fiuba-labo-de-micro-miercoles/2016_1c_trabajo_practico-solar_tracker/README.md

# Solar Tracker

Para configurar el oscilador externo a 8MHz:

  avrdude -c usbtiny -p m88 -U lfuse:r:-:i -F		
  avrdude -c usbtiny -p m88 -U lfuse:w:0xE2:m -F

# ¡GRACIAS A LOS QUE HICIERON POSIBLE ESTE PROYECTO!
