fiuba-labo-de-micro-miercoles/2016_1c_trabajo_practico-solar_tracker/(threads)

Thread 1 (2016-05-19):

Crear pdf con el esquemático

ggavinowich, 2016-05-19:
Hola, buenísimo que hayan subido el esquemático. ¿Pueden por favor subir una versión en pdf para que podamos verla sin tener que instalar el Kicad?

Mecanigio, 2016-05-26:
Perdon, recien lo veo! ahi subi el esquemático en pdf.

Saludos!

Equipo Solar Tracker.

Closed 2016-05-26.

Thread 2 (2016-05-30):

¿Parte de mecánica?

fbaglivo, 2016-05-30:
Estimados, buenísimo que mantengan actualizado el repo.

Les quería preguntar si uds ya tienen resuelta la parte mecánica (como montar el panel, si van a hacer algo a escala y van a usar un panel chico, etc).

GedSid, 2016-05-30:
Estamos en eso, tenemos un par de cosas resueltas y un par más por
resolver. Durante esta semana esperamos resolverlo, para la semana que
viene inprimir los engranajes.
La idea es no hacer una maqueta, sino el aparato definitivo.

Saludos,
Joaquín Ulloa
El 30/05/2016 14:55, "fbaglivo" <notifications@github.com> escribió:

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

Closed 2016-06-03.
