fiuba-labo-de-micro-miercoles/2016_1c_trabajo_practico-solar_tracker/esquematico/TP LDM KICAD/Archivos_Frabricacion/TP-F.Cu.pdf

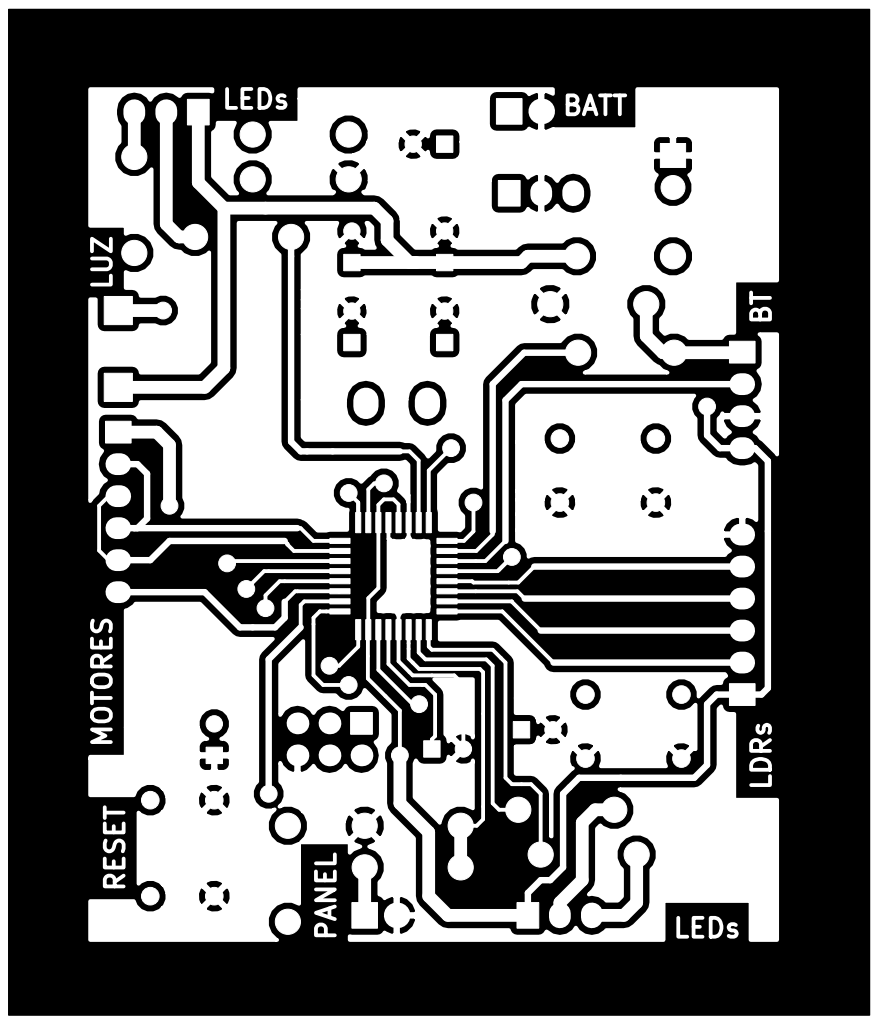
[picture p8: page 1]

BT LDRs PANEL LEDs RESET MOTORES LUZ
