fiuba-labo-de-micro-miercoles/2016_1c_trabajo_practico-solar_tracker/esquematico/TP LDM KICAD/ESQUEMATICO.pdf

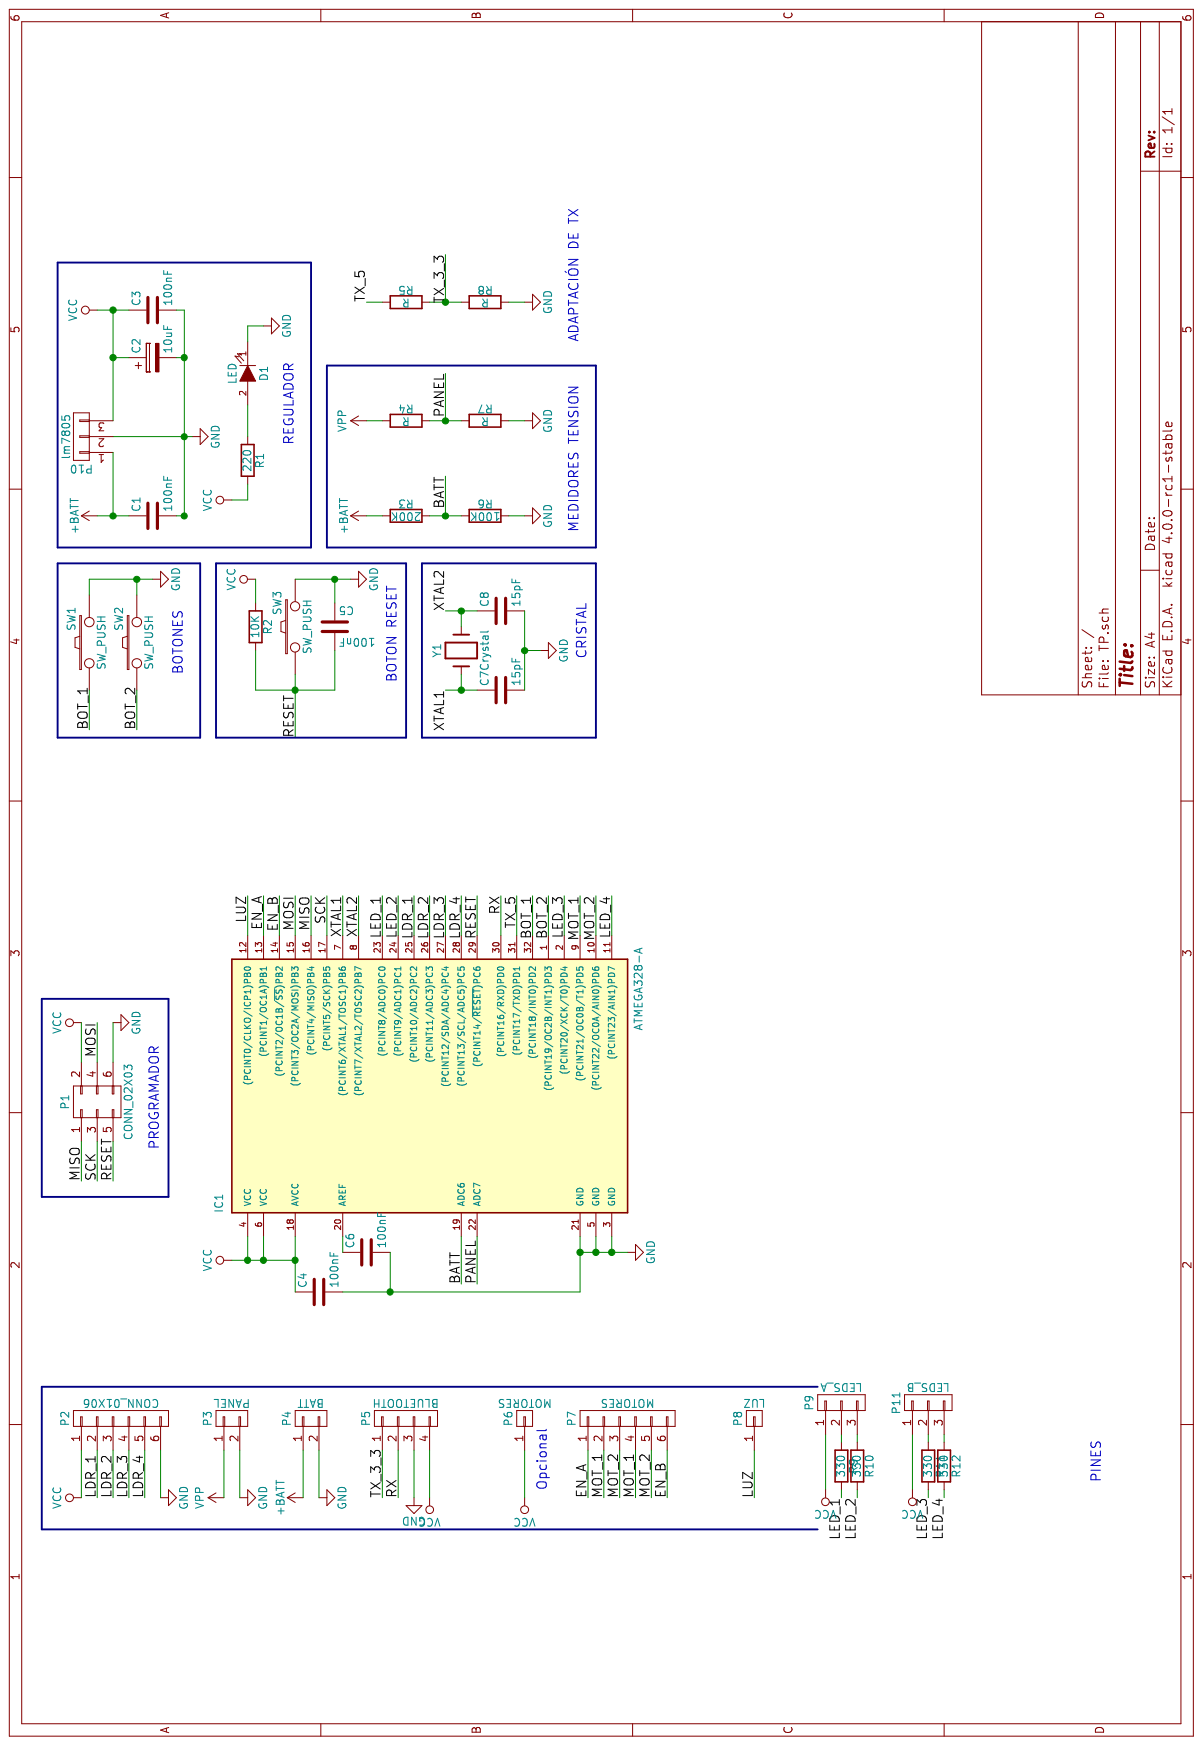
[picture p9: page 1]
