fiuba-labo-de-micro-miercoles/2016_1c_trabajo_practico-solar_tracker/esquematico/TP LDM KICAD/Archivos_Frabricacion/TP-B.Cu.pdf

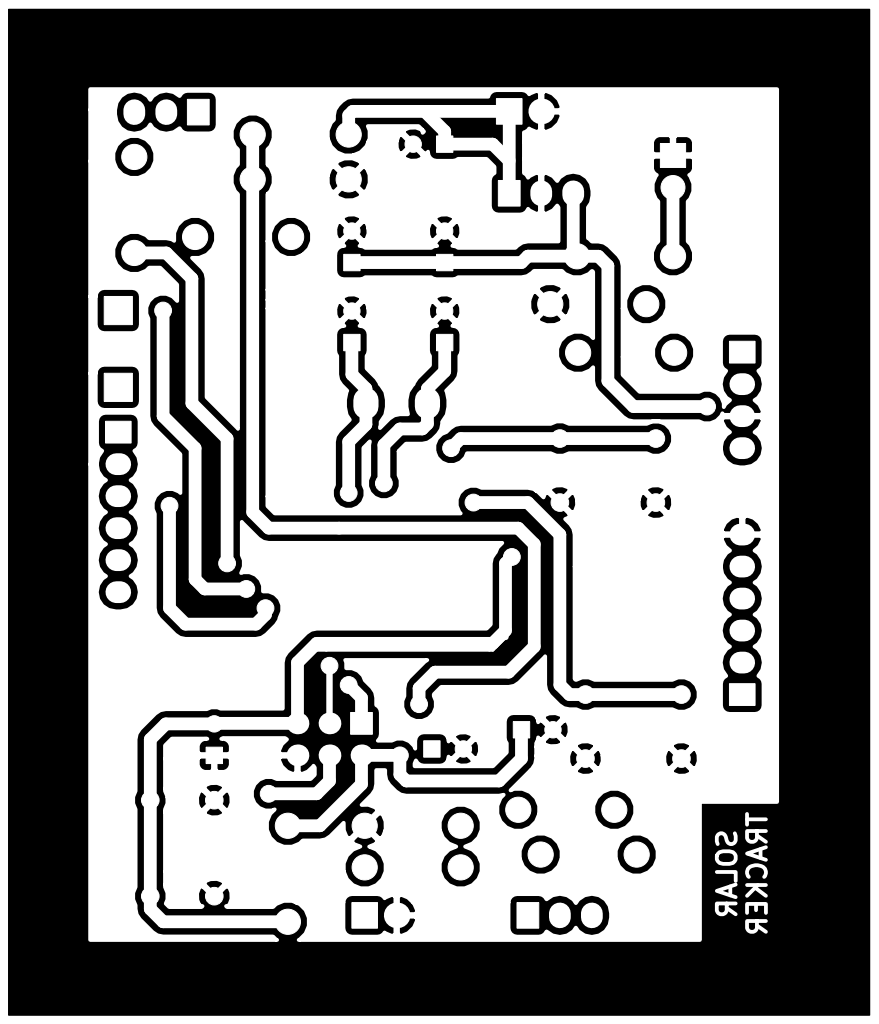
[picture p10: page 1]
