fiuba-labo-de-micro-miercoles/2016_1c_trabajo_practico-solar_tracker/esquematico/TP LDM KICAD/TP.kicad_pcb

## KiCad design esquematico/TP LDM KICAD/TP.kicad_pcb (2016-05-13)

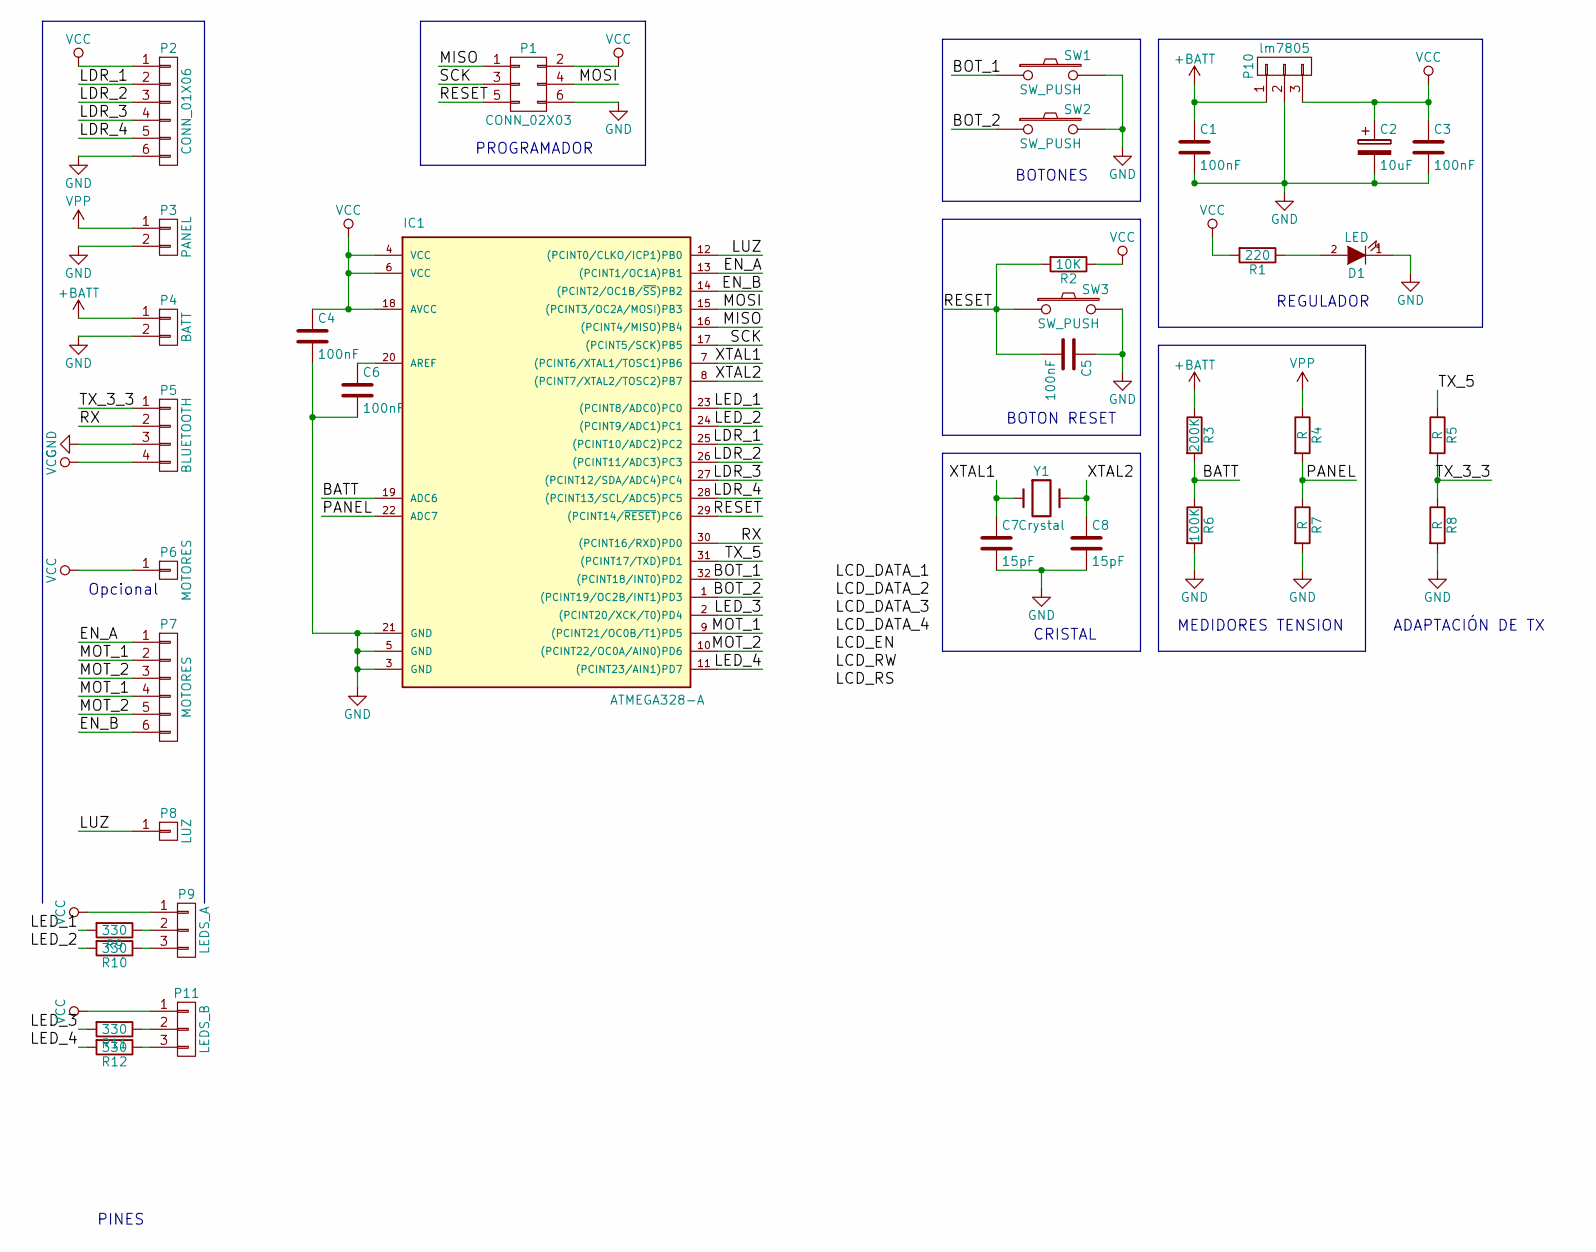
[picture p11: schematic TP.sch]

Parts:
C1, C3, C4, C5, C6: 100nF; C_Radial_D5_L6_P2.5
C2: 10uF; C_Radial_D5_L6_P2.5
C7, C8: 15pF; C_Radial_D5_L6_P2.5
D1: LED; LED-5MM
IC1: ATMEGA328-A; ATMEGA328PARALCI
P1: CONN_02X03; Pin_Header_Straight_2x03
P2: CONN_01X06; Pin_Header_Straight_1x06
P3: PANEL; Pin_Header_Straight_1x02
P4: BATT; Pin_Header_Straight_1x02
P5: BLUETOOTH; Pin_Header_Straight_1x04
P6: MOTORES; Pin_Header_Straight_1x01
P7: MOTORES; Pin_Header_Straight_1x06
P8: LUZ; Pin_Header_Straight_1x01
P9: LEDS_A; Pin_Header_Straight_1x03
P10: lm7805; Pin_Header_Straight_1x03
P11: LEDS_B; Pin_Header_Straight_1x03
R1: 220; Resistor_Horizontal_RM7mm
R2: 10K; Resistor_Horizontal_RM7mm
R3: 200K; Resistor_Horizontal_RM7mm
R4, R5, R7, R8: R; Resistor_Horizontal_RM7mm
R6: 100K; Resistor_Horizontal_RM7mm
R9, R10, R11, R12: 330; Resistor_Horizontal_RM7mm
SW1, SW2, SW3: SW_PUSH; SW_PUSH_SMALL
Y1: Crystal; Crystal_HC50-U_Vertical

Connections:
+BATT: C1.1, P4.1, P10.1, R3.1
/BATT: IC1.19 (ADC6), R3.2, R6.1
/BOT_1: IC1.32 ((PCINT18/INT0)PD2), SW1.1
/BOT_2: IC1.1 ((PCINT19/OC2B/INT1)PD3), SW2.1
/EN_A: IC1.13 ((PCINT1/OC1A)PB1), P7.1
/EN_B: IC1.14 ((PCINT2/OC1B/~SS~)PB2), P7.6
/LDR_1: IC1.25 ((PCINT10/ADC2)PC2), P2.2
/LDR_2: IC1.26 ((PCINT11/ADC3)PC3), P2.3
/LDR_3: IC1.27 ((PCINT12/SDA/ADC4)PC4), P2.4
/LDR_4: IC1.28 ((PCINT13/SCL/ADC5)PC5), P2.5
/LED_1: IC1.23 ((PCINT8/ADC0)PC0), R9.2
/LED_2: IC1.24 ((PCINT9/ADC1)PC1), R10.2
/LED_3: IC1.2 ((PCINT20/XCK/T0)PD4), R11.2
/LED_4: IC1.11 ((PCINT23/AIN1)PD7), R12.2
/LUZ: IC1.12 ((PCINT0/CLKO/ICP1)PB0), P8.1
/MISO: IC1.16 ((PCINT4/MISO)PB4), P1.1
/MOSI: IC1.15 ((PCINT3/OC2A/MOSI)PB3), P1.4
/MOT_1: IC1.9 ((PCINT21/OC0B/T1)PD5), P7.2, P7.4
/MOT_2: IC1.10 ((PCINT22/OC0A/AIN0)PD6), P7.3, P7.5
/PANEL: IC1.22 (ADC7), R4.2, R7.1
/RESET: C5.2, IC1.29 ((PCINT14/~RESET~)PC6), P1.5, R2.2, SW3.1
/RX: IC1.30 ((PCINT16/RXD)PD0), P5.2
/SCK: IC1.17 ((PCINT5/SCK)PB5), P1.3
/TX_3_3: P5.1, R5.2, R8.1
/TX_5: IC1.31 ((PCINT17/TXD)PD1), R5.1
/XTAL1: C7.1, IC1.7 ((PCINT6/XTAL1/TOSC1)PB6), Y1.1
/XTAL2: C8.1, IC1.8 ((PCINT7/XTAL2/TOSC2)PB7), Y1.2
GND: C1.2, C2.2, C3.2, C4.2, C5.1, C6.2, C7.2, C8.2, D1.1 (K), IC1.3 (GND), IC1.5 (GND), IC1.21 (GND), P1.6, P2.6, P3.2, P4.2, P5.3, P10.2, R6.2, R7.2, R8.2, SW1.2, SW2.2, SW3.2
unnamed: C6.1, IC1.20 (AREF)
unnamed: D1.2 (A), R1.1
unnamed: P9.2, R9.1
unnamed: P9.3, R10.1
unnamed: P11.2, R11.1
unnamed: P11.3, R12.1
VCC: C2.1, C3.1, C4.1, IC1.4 (VCC), IC1.6 (VCC), IC1.18 (AVCC), P1.2, P2.1, P5.4, P6.1, P9.1, P10.3, P11.1, R1.2, R2.1
VPP: P3.1, R4.1

Notes on the sheet:
Opcional
BOTONES
BOTON RESET
CRISTAL
PINES
REGULADOR
MEDIDORES TENSION
PROGRAMADOR
ADAPTACIÓN DE TX

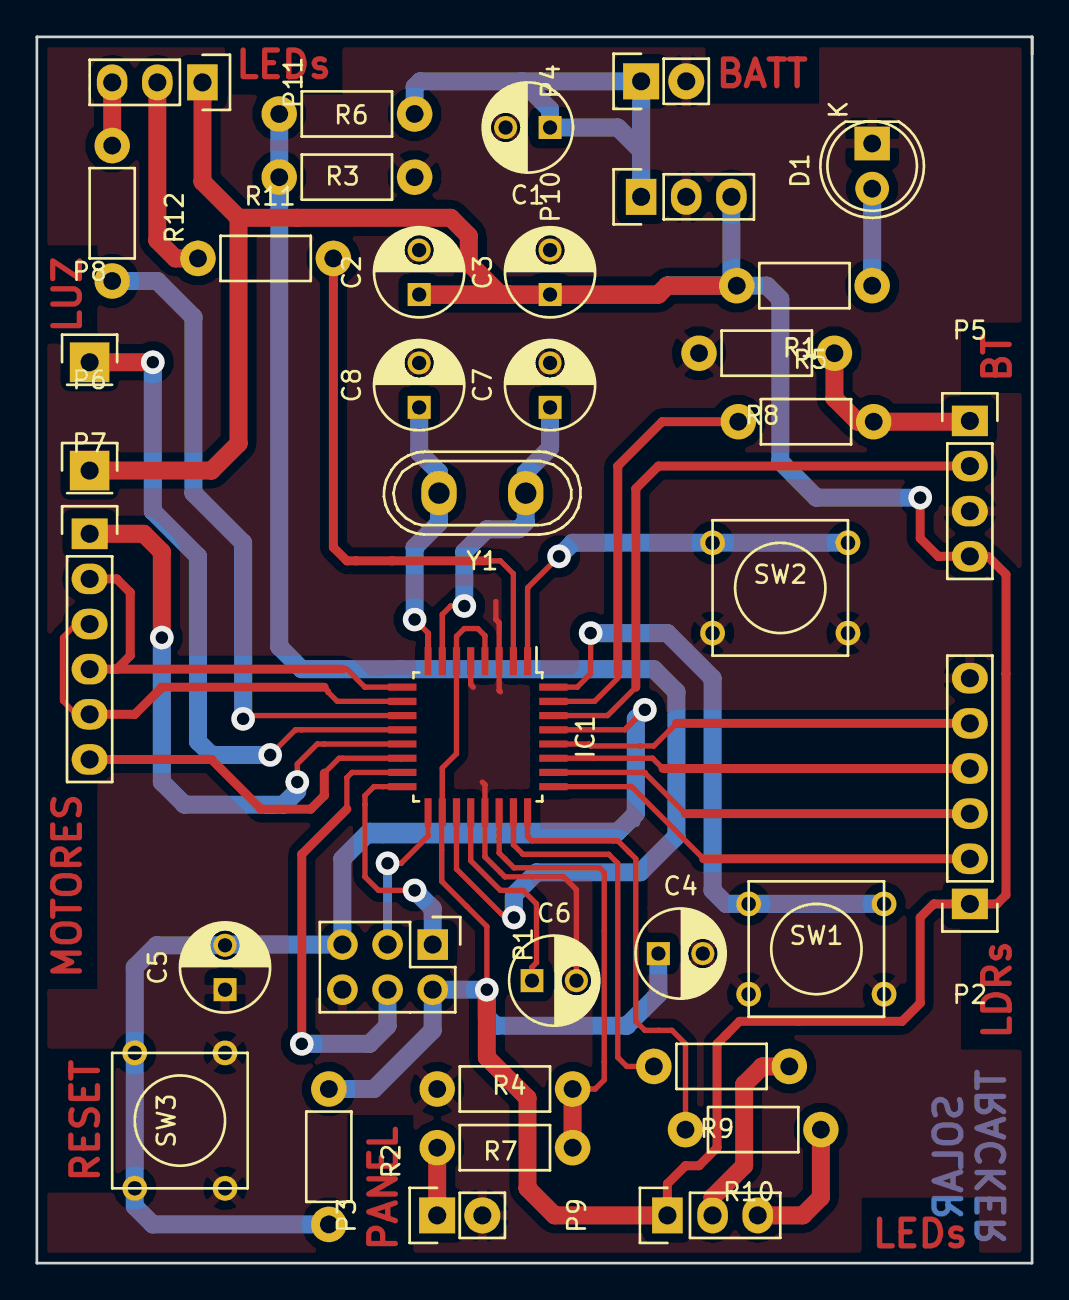
[picture p12: board TP.kicad_pcb from above]

Board: 2 copper layers, 56.0 x 69.0 mm, 37 parts (0 on the bottom side), 36 nets.
