fiuba-labo-de-micro-miercoles/2016_1c_trabajo_practico-solar_tracker/(commit log)

2016-05-11 Add files via upload
    Se sube el anteproyecto.
2016-05-11 Add files via upload
    Se suben los diagramas de flujo y bloques
2016-05-11 Add files via upload
    Se sube la convención de uso de registros preliminar.
2016-05-11 Add files via upload
    Se sube la hoja de datos de la familia del micro a usar
2016-05-13 Ahí subí el proyecto en kicad. SEGURO tira error en el ATMEGA328PARALCI.kicad_mod cuando vayas a seguir ruteando Joaco.
    [TP.kicad_pcb, TP.sch]
2016-05-13 V 1.0 terminada PCB micro + archivos fabricacion LCI
    [TP.kicad_pcb, TP.sch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]
2016-05-13 agrego RAR con archivos de fabricacion
2016-05-13 Ya tenemos puerto serie para el atmega88pa
2016-05-19 prueba con el bluetooth [esta mal el nombre]
2016-05-26 Prueba del ADC.. para variar no anda tdv jaja
2016-05-27 Codigo PWM. A las dos salidas de 8bit solo les falta una mascara y estan. Las de 16bit no estan configuradas todavia.
2016-05-27 aca subo andando el ADC
2016-05-27 No esta testeado
    Falta el PWM de 16bits, se hara cuando ande el de 8bits
2016-05-27 ahi subo el pwm de joaco andando
2016-05-29 Agrego hojas de datos de micro, controlador de carga de panel solar y algunas especificaciones de motores
2016-05-29 Revert "Agrego hojas de datos de micro, controlador de carga de panel solar y algunas especificaciones de motores"
    This reverts commit 7b0eeaa5e9d731c8c791ec66e3d50fa0e535bb60.
2016-05-29 Es un seudo codigo pedorro, basica mente lo mismo que el diagram de bloques. Pero sirvio para darme cuenta que nos falta aprender como hacer una interrupcion serie e ir y salir de modo bajo consumo.
2016-05-29 Agrego el codijo de pwm del puerto b supuestamente terminada y paso todo el codigo de prueba a la carpeta prueba
2016-05-29 borro el leeme
2016-05-29 erregle una cagada que me habia mandado con pwm_b
2016-05-29 Agrego codigo para PWM puerto D, 16bits, pero usado como de 8
2016-05-30 arreglo de mascaras, funciones set y reset
2016-05-30 me molesta que esté!
2016-05-30 Segmento de codigo de las rutinas de delay. HANDICAP
2016-05-30 basico. falta terminar. idea del modulo ADC
2016-05-30 basico. falta terminar. idea del modulo pwm
2016-05-30 arreglo de errores en pwm_d y modificar el main de solar tracker
2016-05-30 agrego la funcion para seleccionar la entrada
2016-05-30 empece con el puerto serie. HAY QUE HACERLO POR INTERRUPCION
2016-06-01 archivo con funciones de la luz
2016-06-01 archivo con las frases para transmitir
2016-06-01 definicion de constantes y registros de todo el proyecto
2016-06-01 pase las directivas de preprocesador al header general del proyecto
2016-06-02 LO QUE HICIMOS EN CLASE
    [TP.sch]
2016-06-02 cambios que me acorde antes de dormir. chequear mañana mas lucido
2016-06-05 empece a hacer la lectura de ldrs gracias a agus
2016-06-06 para futura implementacion con LCD
2016-06-06 cambios hechos en el labi
2016-06-08 Aplique los cambios que dijo Ricardo Arias sobre el buffer
2016-06-08 codigo de Agus. Las ideas ya las puse en LDRS.inc
2016-06-08 version con todos los PWM necesarios
2016-06-08 ya estan listos los pwm y las macros para set y reset
2016-06-08 empezando a hacer lo de mover motores
2016-06-13 cambie en el esquematico la luz, siguen faltando funciones de conversion, cambios generales. Tp VIRTUALMENTE funcionando
    [TP.sch]
2016-06-17 hice un proyecto aparte para pruebas antes de ir al definitivo
2016-06-17 ahi agregue la funcion de pycard de convertir del adc al dato a transmitir
2016-06-18 andando adc (ldrs,bateria y panel), puerto serie y el resto probar
2016-06-18 andando bateria, panel solar, logica luz y el sleep en el main. faltan motores, calibrar motores, y calibrar panel y ldrs
2016-06-18 despues que se fueron joaco y agus. manda la tension por bt. supongo que todo lo anterior sigue andando
2016-06-19 ANDAN LOS MOTORES, FALTA ORIENTAR EL PANEL EN FUNCION DE LDRS (QUE ANDAN ESTOS ULTIMOS) Y FALTA AGREGAR BT Y CHEQUEAR QUE ANDE BIEN EL SLEEP
2016-06-19 AHORA SI ANDAN BIEN LOS MOTORES! CONFIGURABAMOS MAL TCCR1A EN PWM git add .git add .
2016-06-19 se agregaron smooth_move y smooth_brake para que no cabecee y ORIENTATE_SOLAR_PANEL anda en el eje azimutal y no se mueve en maxima luz. FALTA elevacion.
2016-06-19 ANDA EL SLEEP_MODE CON TIMER, EN CONJUNTO CON EL PROYECTO. CHEQUEAR QUE HACE ALGO RARO CON LA TRANSMISION DE DATOS POR BT
2016-06-20 cuando sale de VBATERRY_TO_ASCII vuelva a cualquier lado. hace lio con PC, pero convierte bien
2016-06-20 anda todo, excepto un bug en la lectura de la tension del panel. falta probar la luz y hacer lindo la comunicacion bluetooth.
2016-06-21 chequear la calibracion, cuando se va a dormir y la luz
2016-06-22 ajustes despues de que anduvo bien. La luz se ajusta segun la carga de la bateria, el panel esta ajustado para luz de interior. no probe las comparaciones de ldrs. POR PROBLEMAS EN LOS LDRS, volver a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
2016-06-22 En la funcion ORIENTATE_SOLAR_PANEL tome el promedio para comparar.
2016-06-29 subo el informe en pdf
